Dahlia-Dry/34346-bikelight/34346-Slides.pdf

## 34346 Networking Technologies and Application Development for IoT

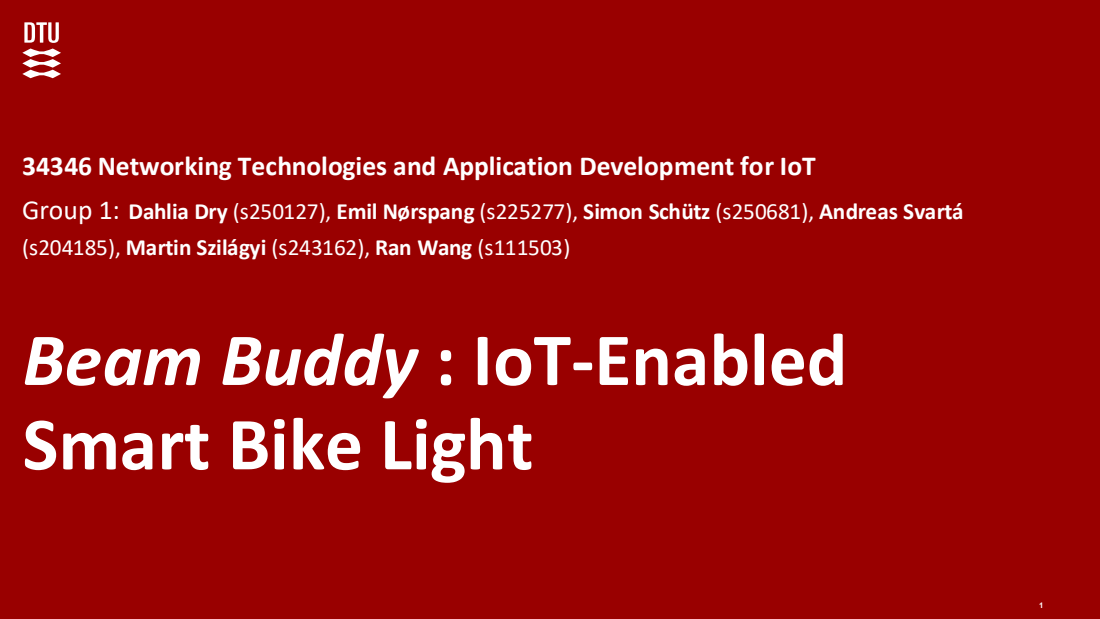
[picture p3: page 1]

Group 1: Dahlia Dry (s250127), Emil Nørspang (s225277), Simon Schütz (s250681), Andreas Svartá
(s204185), Martin Szilágyi (s243162), Ran Wang (s111503)
Beam Buddy : IoT-Enabled
Smart Bike Light

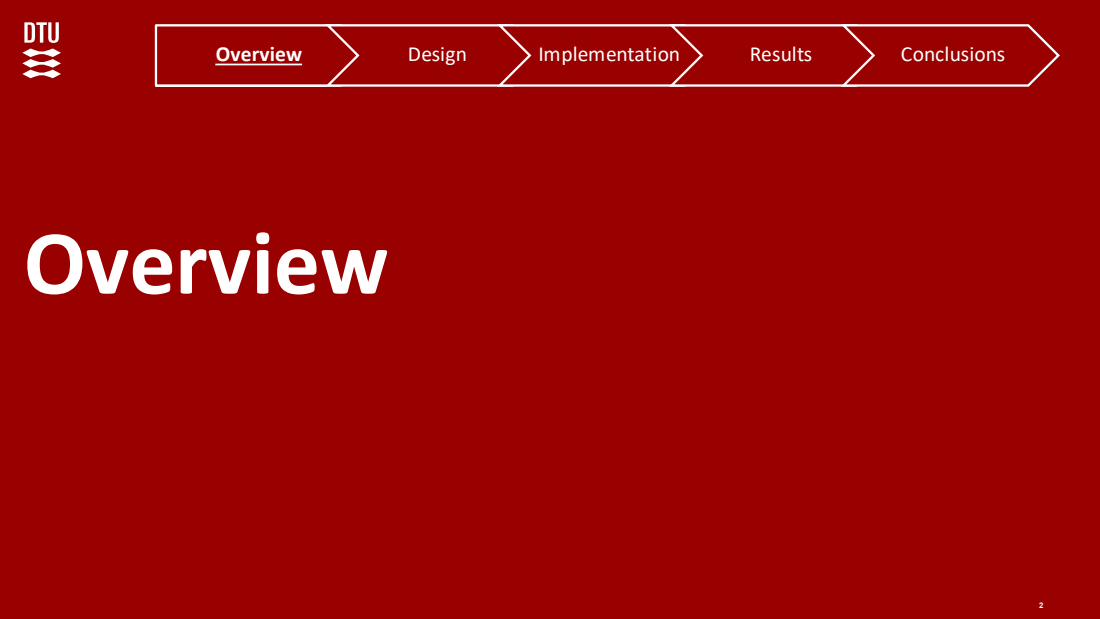
[picture p4: page 2]
Overview; Design; Implementation; Results; Conclusions

# Problem statement

## Bike lights are a critical safety component for any cyclist, but they are often

unreliable (run out of battery), easily stolen, or easy to forget.

3

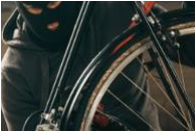
[picture p5: figure]
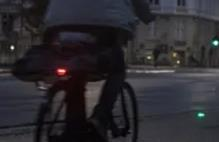
[picture p6: figure]

# Our Solution

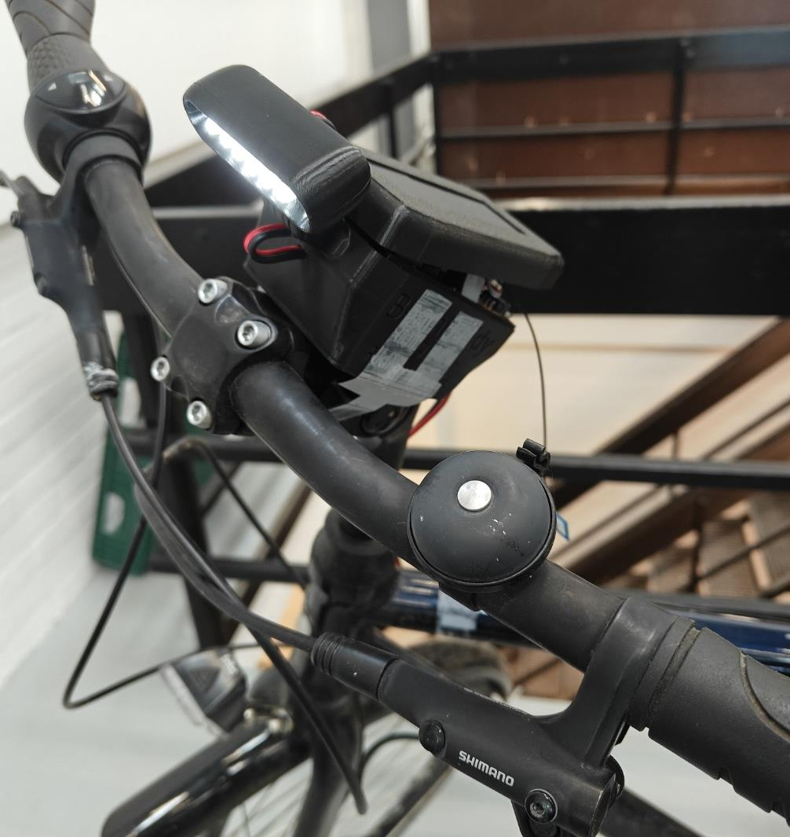
[picture p7: figure]

## - front and rear light - turns on automatically with motion/darkness - theft alarm with RFID card for locking/unlocking the bike when parked - solar charging + audible warning for low battery - Web interface for visualizing operation mode, last seen location, and battery status

4

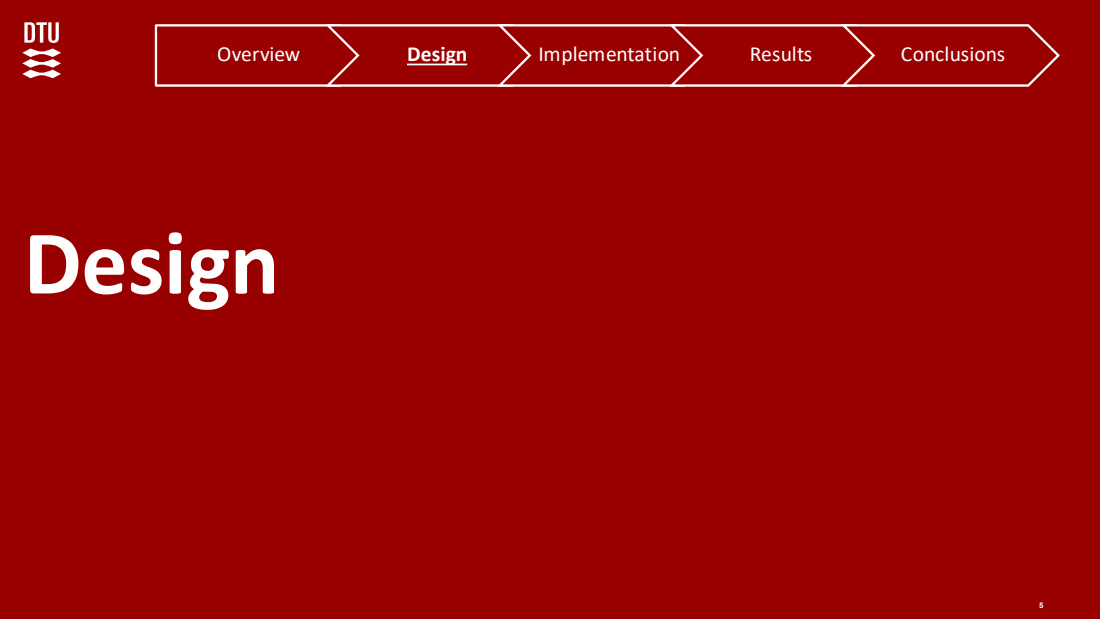
[picture p8: page 5]
Design; Overview; Implementation; Results; Conclusions

# Design

# - prototype

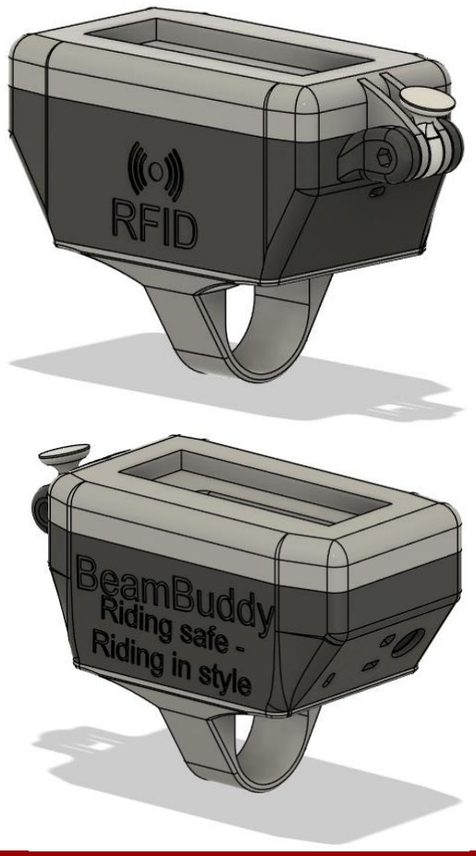
[picture p9: figure]

6

Based on an HT

-CT62 with features:

- Automatic lights w. overwrite button • GPS-tracking using WiFi and GNSS • Movement and light sensors • RFID lock • Theft alarm system • LoRaWAN wireless communication • App communication • Solar & 5V charging capabilities • UV secure casing

# Enclosure

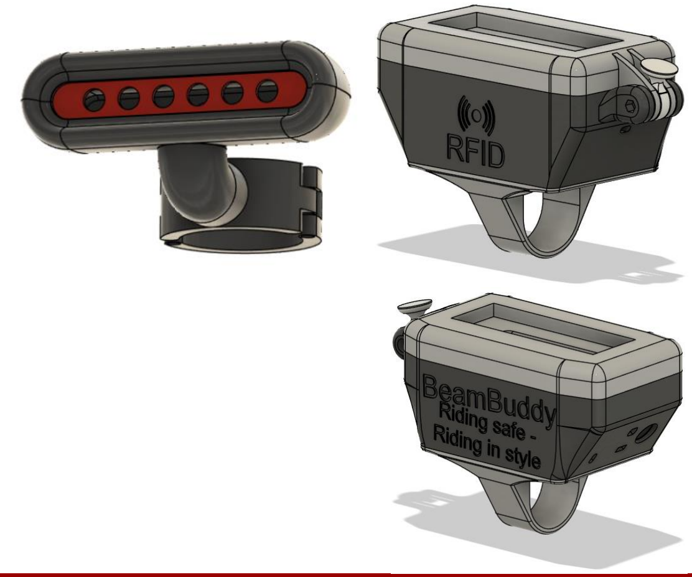
[picture p10: figure]

7

- Waterproof capable
- UV resistant
- Secure anti-theft mounting
- 3D Printed
- PETG casing

# Hardware Design

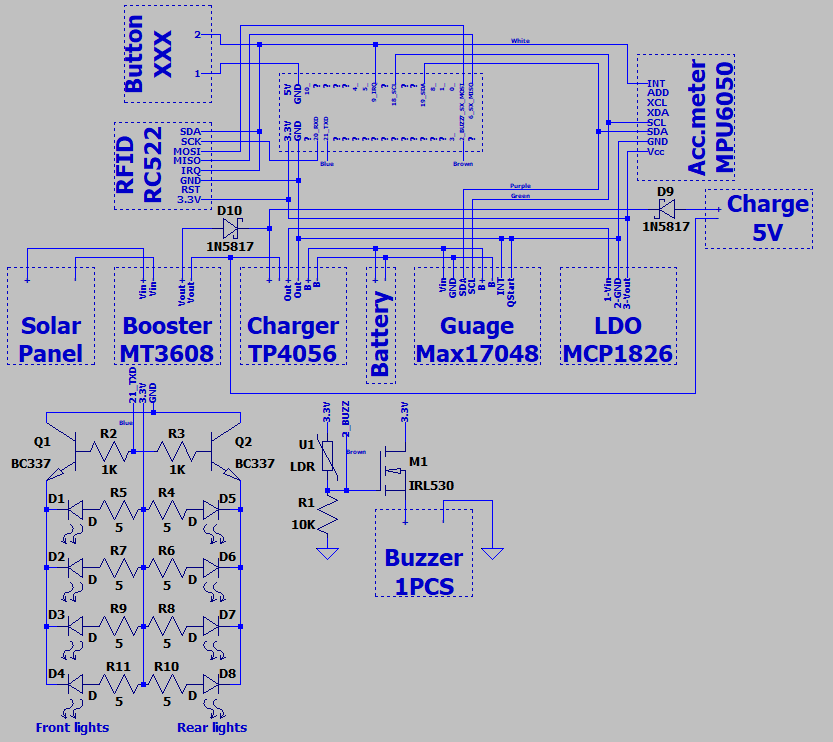
[picture p11: figure]

8

- Heltec HT

-CT62 Development Board (ESP32

framework with an SX1262)

- MT3608 Booster • TP4056 Charging circuit • ICR18650-26J battery (3.7V 2600mAH) • MAX17048 Battery Guage • MCP1826 LDO • RC522 RFID read/writer • MPU6050 Accelerometer • 1N5817 Diode protection • BC337 BJT controlling lights • IRL530 MOSFET controlling buzzer

# Software Design

9

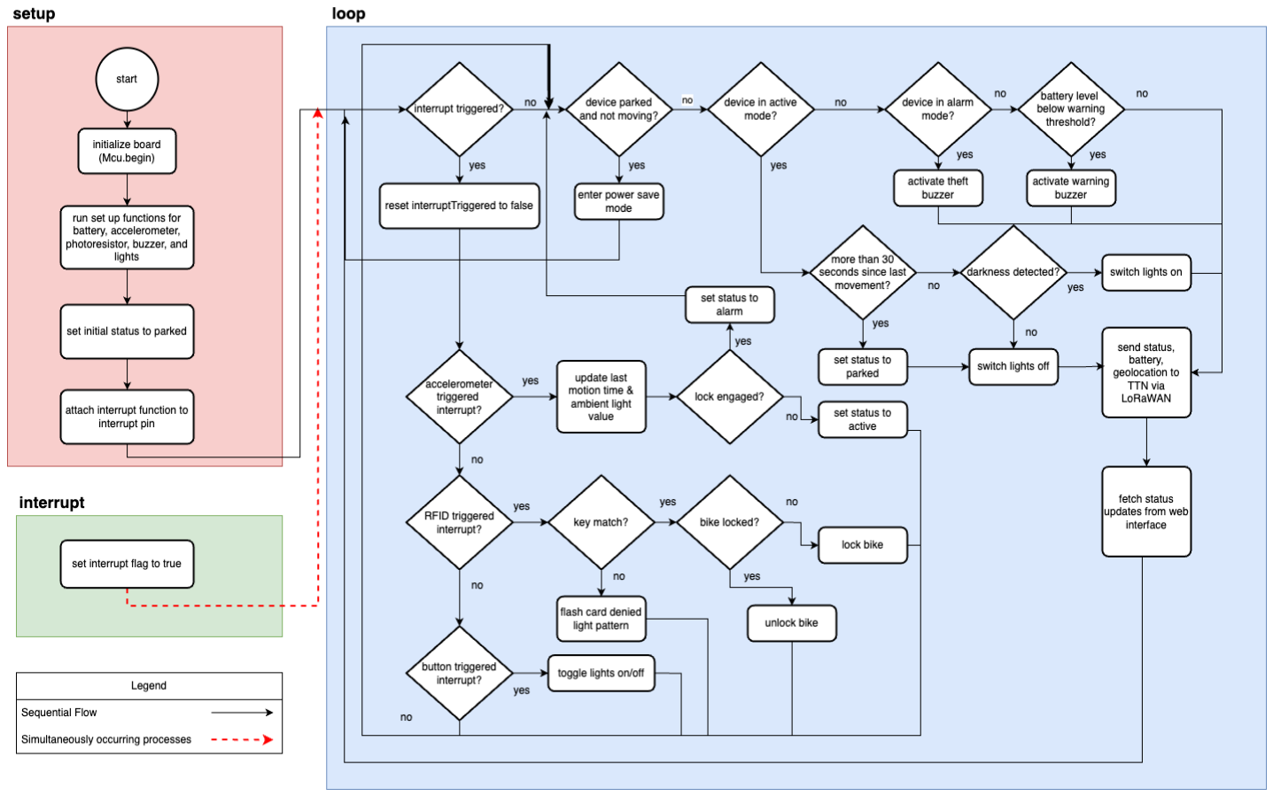
[picture p12: figure]

Operating Modes:
- Storage (deep sleep)
- Parked (locked or unlocked)
- Alarm
- Active

Single interrupt triggered by accelerometer, RFID, or button

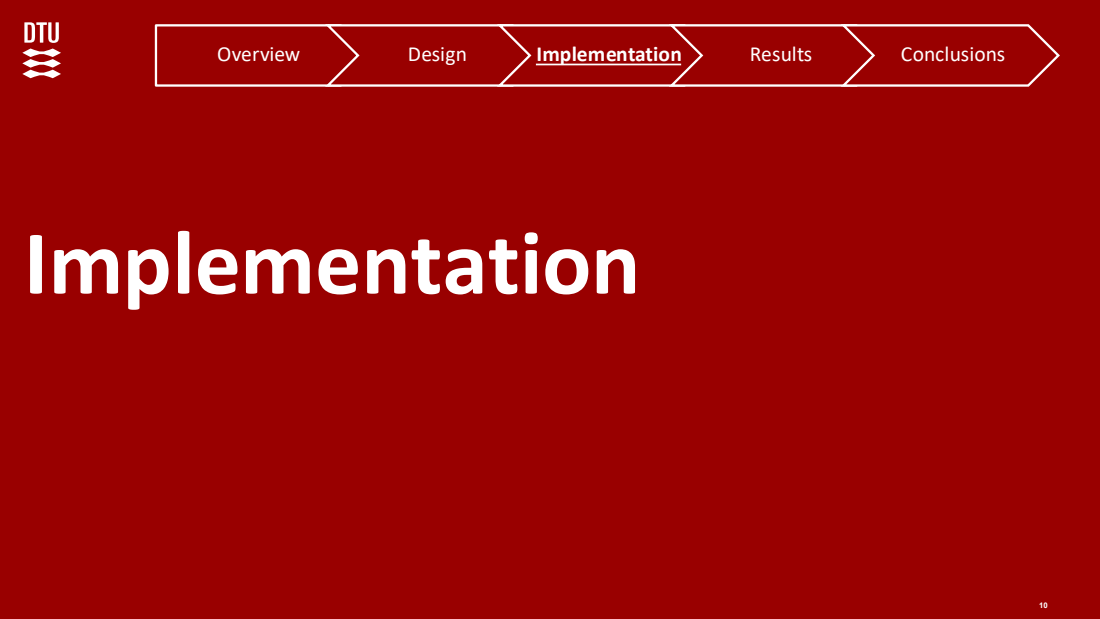
[picture p13: page 10]
Implementation; Overview; Design; Results; Conclusions

# LED Light

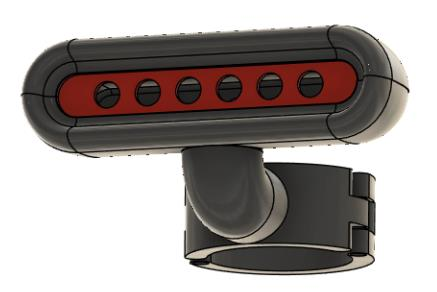
[picture p14: figure]

11

- Automatic turn on/off with motion/light
- Manual overwrite function
- Power efficient visibility light
- Front and rear light
- Angle adjustable front light

# RFID Lock + Theft Alarm

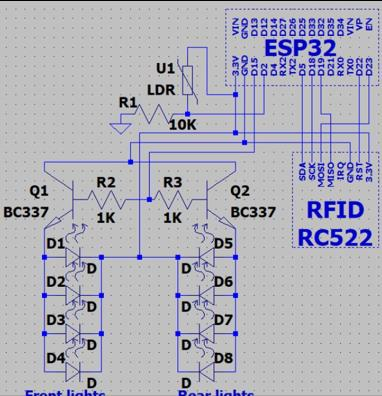
[picture p15: figure]

12

- Rolling FOB – capable
- Multiple Tags
- Locking, unlocking & error light indication
- Movement activated theft alarm
- Audible alarm

# Network technology - LoRaWAN

13

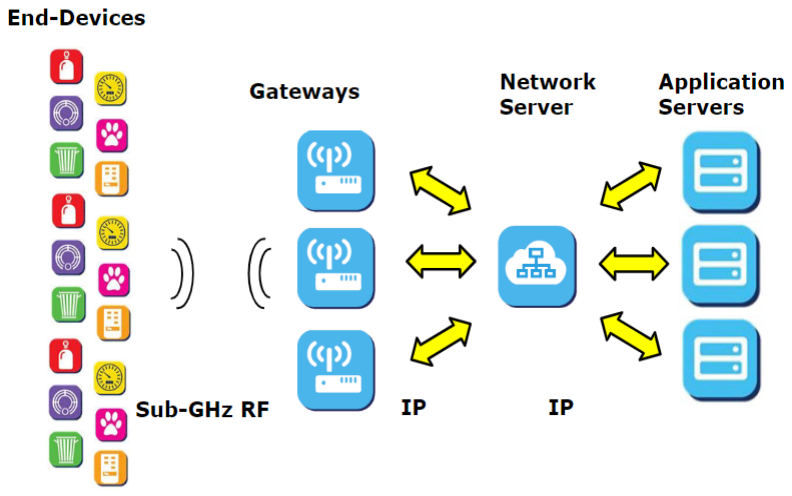
[picture p16: figure]

- Advantages:
– Long range
– Low power consumption
– Cost effective + scalable – Public network (TTN)
- Disadvantages:
– Inconsistent coverage
– susceptible to interference

# Geolocation – WiFi Scanning

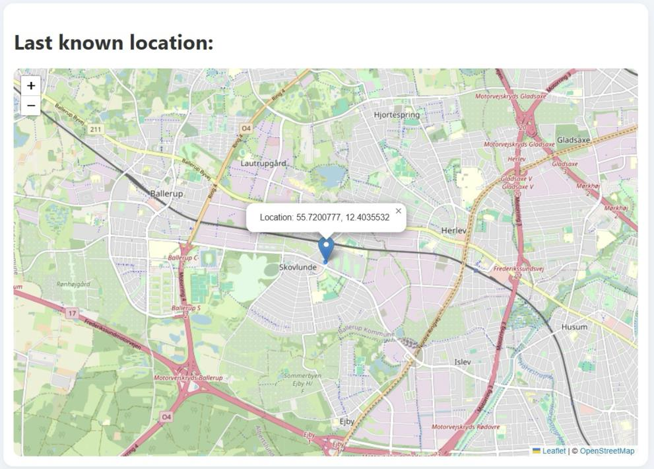
[picture p17: figure]

14

Method:
- The ESP32 board scans for nearby WiFi networks.
- MAC addresses are filtered and compressed.
- Payload of valid MAC addresses + RSSI sent to TTN via LoRaWAN
- Webhook forwards payload to application server (deployed on Railway).
- Google API queries MAC address data and returns geolocation.

# Network technology – Web Integration

15

Comparison of web integration opportunities on TTN. Webhook fits the requirements best.

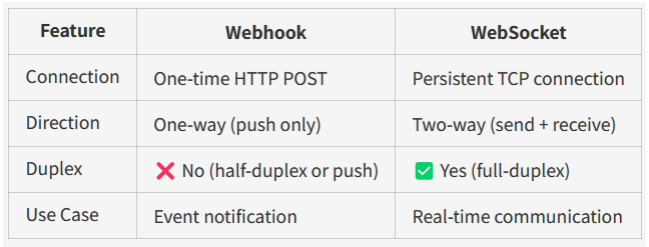
[picture p18: figure]

# Network technology – Application server

16

Backend:
Python
- Parses the JSON structure.
- Decompresses the data.
- Saves the latest data locally in a JSON file to track recent activity.
- Utilizes Google Geolocation API to get position

Frontend:
JavaScript and HTML and CSS.

# Power supply

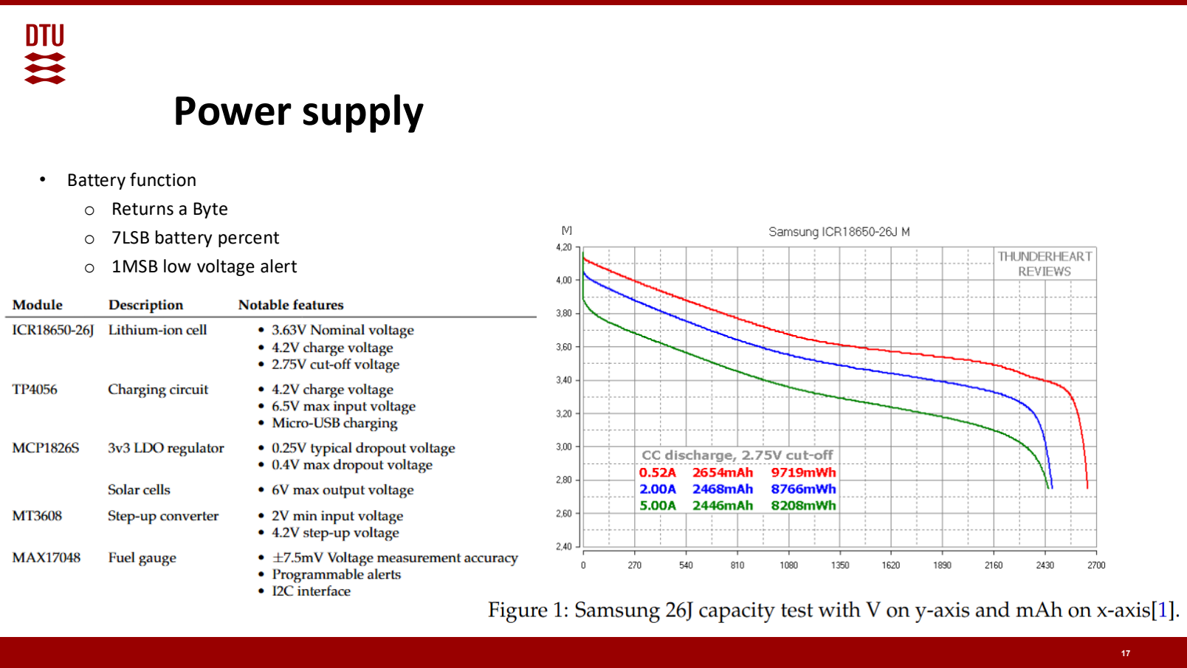
[picture p19: page 17]

17

- Battery function
- Returns a Byte
- 7LSB battery percent
- 1MSB low voltage alert

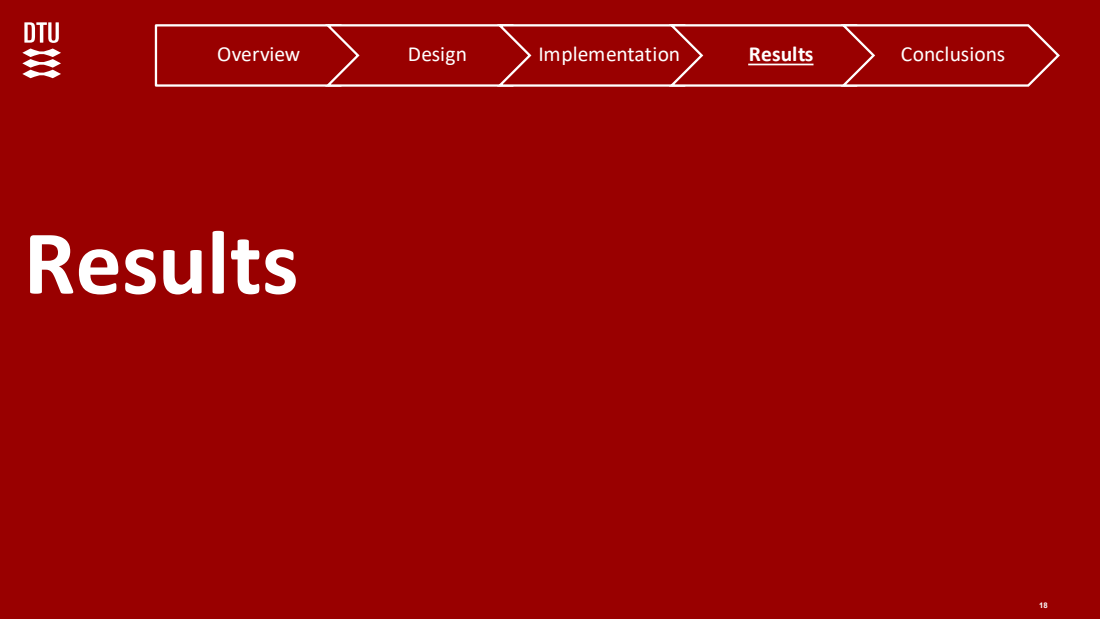
[picture p20: page 18]
Results; Overview; Design; Implementation; Conclusions

# Final Product

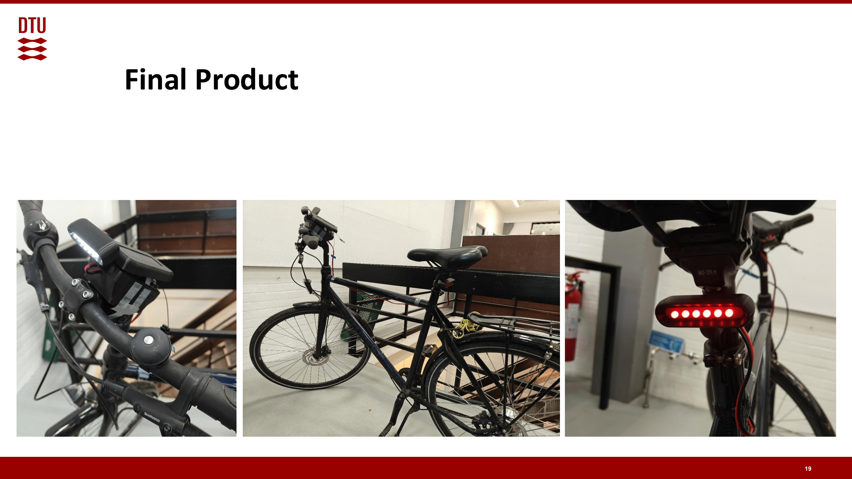
[picture p21: page 19]

19

# Graphical User Interface

20

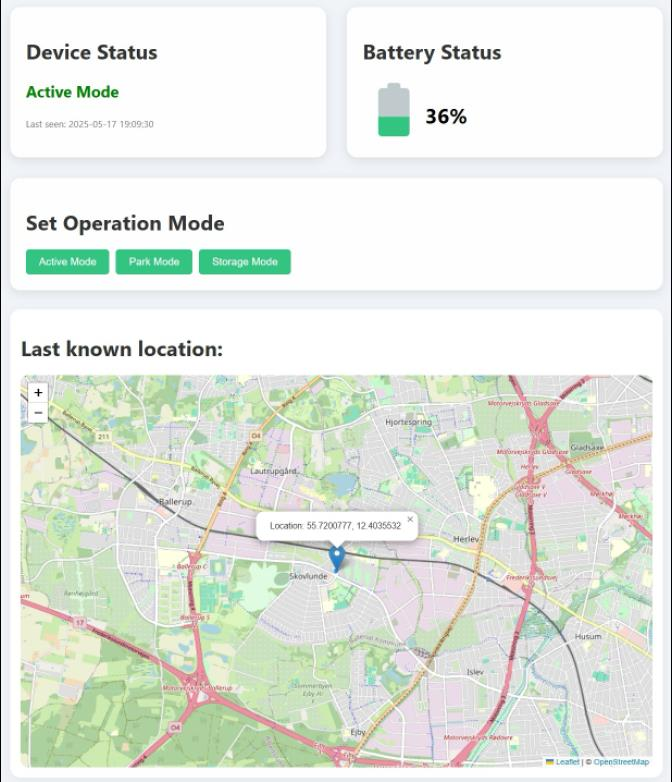
[picture p22: figure]

- Displays battery status, last known location, and current operation mode
- Stores last known data in a JSON file
- Option to set operation mode
- Works on mobile and desktop

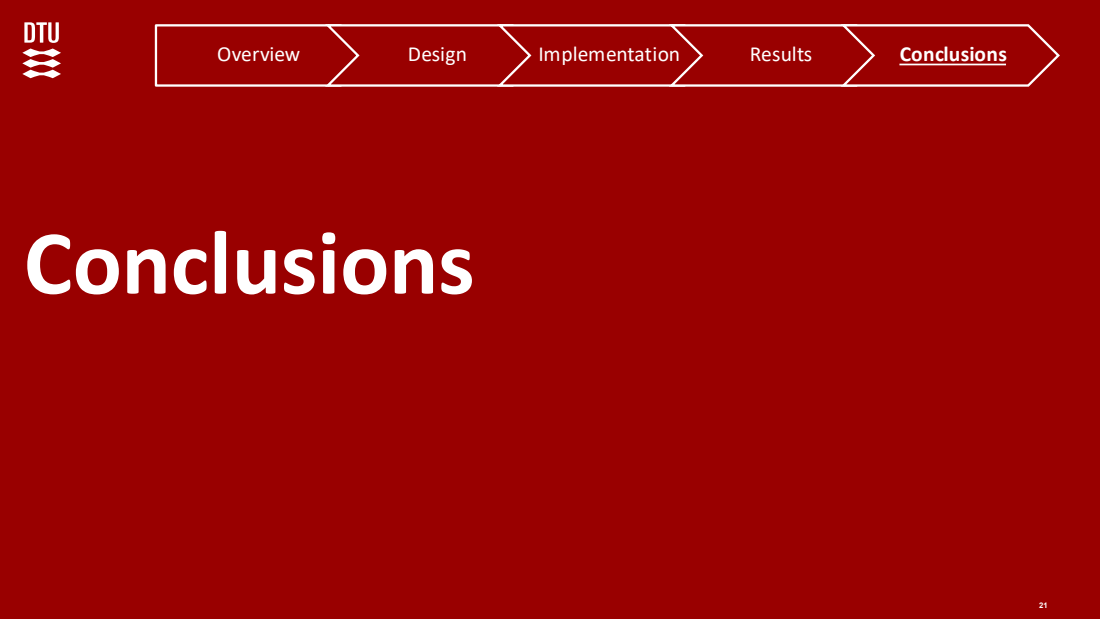
[picture p23: page 21]
Conclusions; Overview; Design; Implementation; Results

# Future Improvement: Solar charging

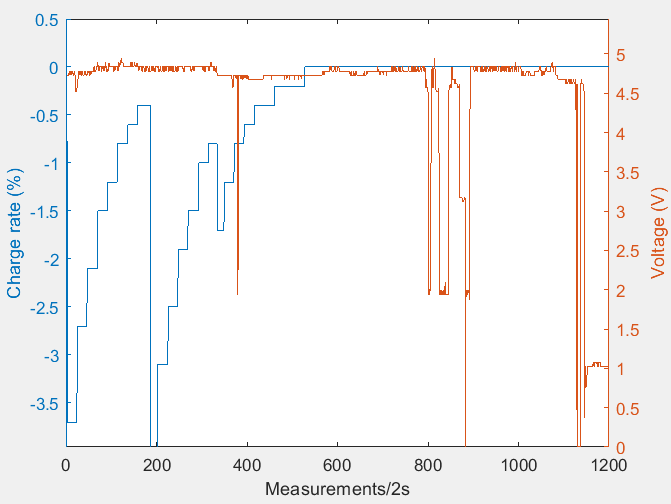
[picture p24: figure]

22

- Problems:
- Produces 5V in direct sunlight.
- At charging circuit voltage too close to charging voltage.
- Step up converter set too low 4.25V, and not suitable for fluctuating inputs.
- Solutions:
- More efficient solar panels with a buck converter.
- Adjusting the step-up converter or removing it.
- Dedicated solar charging circuit.

# Future Improvement: GNSS for Geolocation

Dual mode: WIFI scanning and GNSS module.

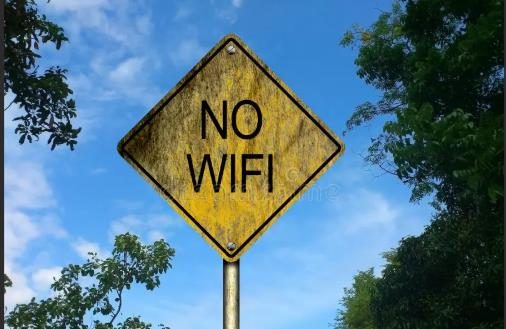
[picture p25: figure]

- In urban area send MAC address and RSSI to Google API to get geolocation.
- In rural area when no WIFI available, use GNSS.(Not in the final code due to restrictions)

23

# Summary

- Complete Successes
- 3D design (compact enclosure) w/front and rear light
- Low power geolocation w/wifi scanning
- Lights responsive to motion + ambient light
- Web interface displaying current battery, status and last known location
- Partial Successes
- RFID anti theft lock (needs further testing)
- Set status from web interface w/LoRaWAN downlink (unreliable)
- Limitations
- Brownout issue causing reset
- Sparse LoRaWAN network coverage
- No deep sleep mode

24
