Dahlia-Dry/34346-bikelight/Schematic and PCB/Beambuddy3D.png

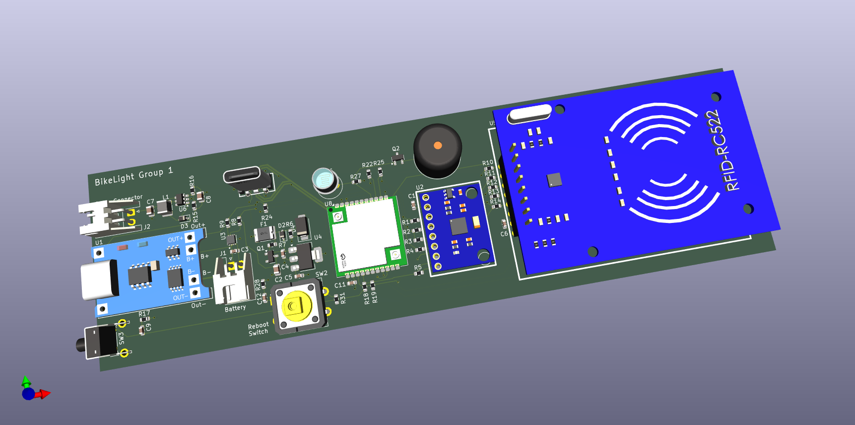
Schematic and PCB/Beambuddy3D.png
