Dahlia-Dry/34346-bikelight/Schematic and PCB/BeamBuddySCH.pdf

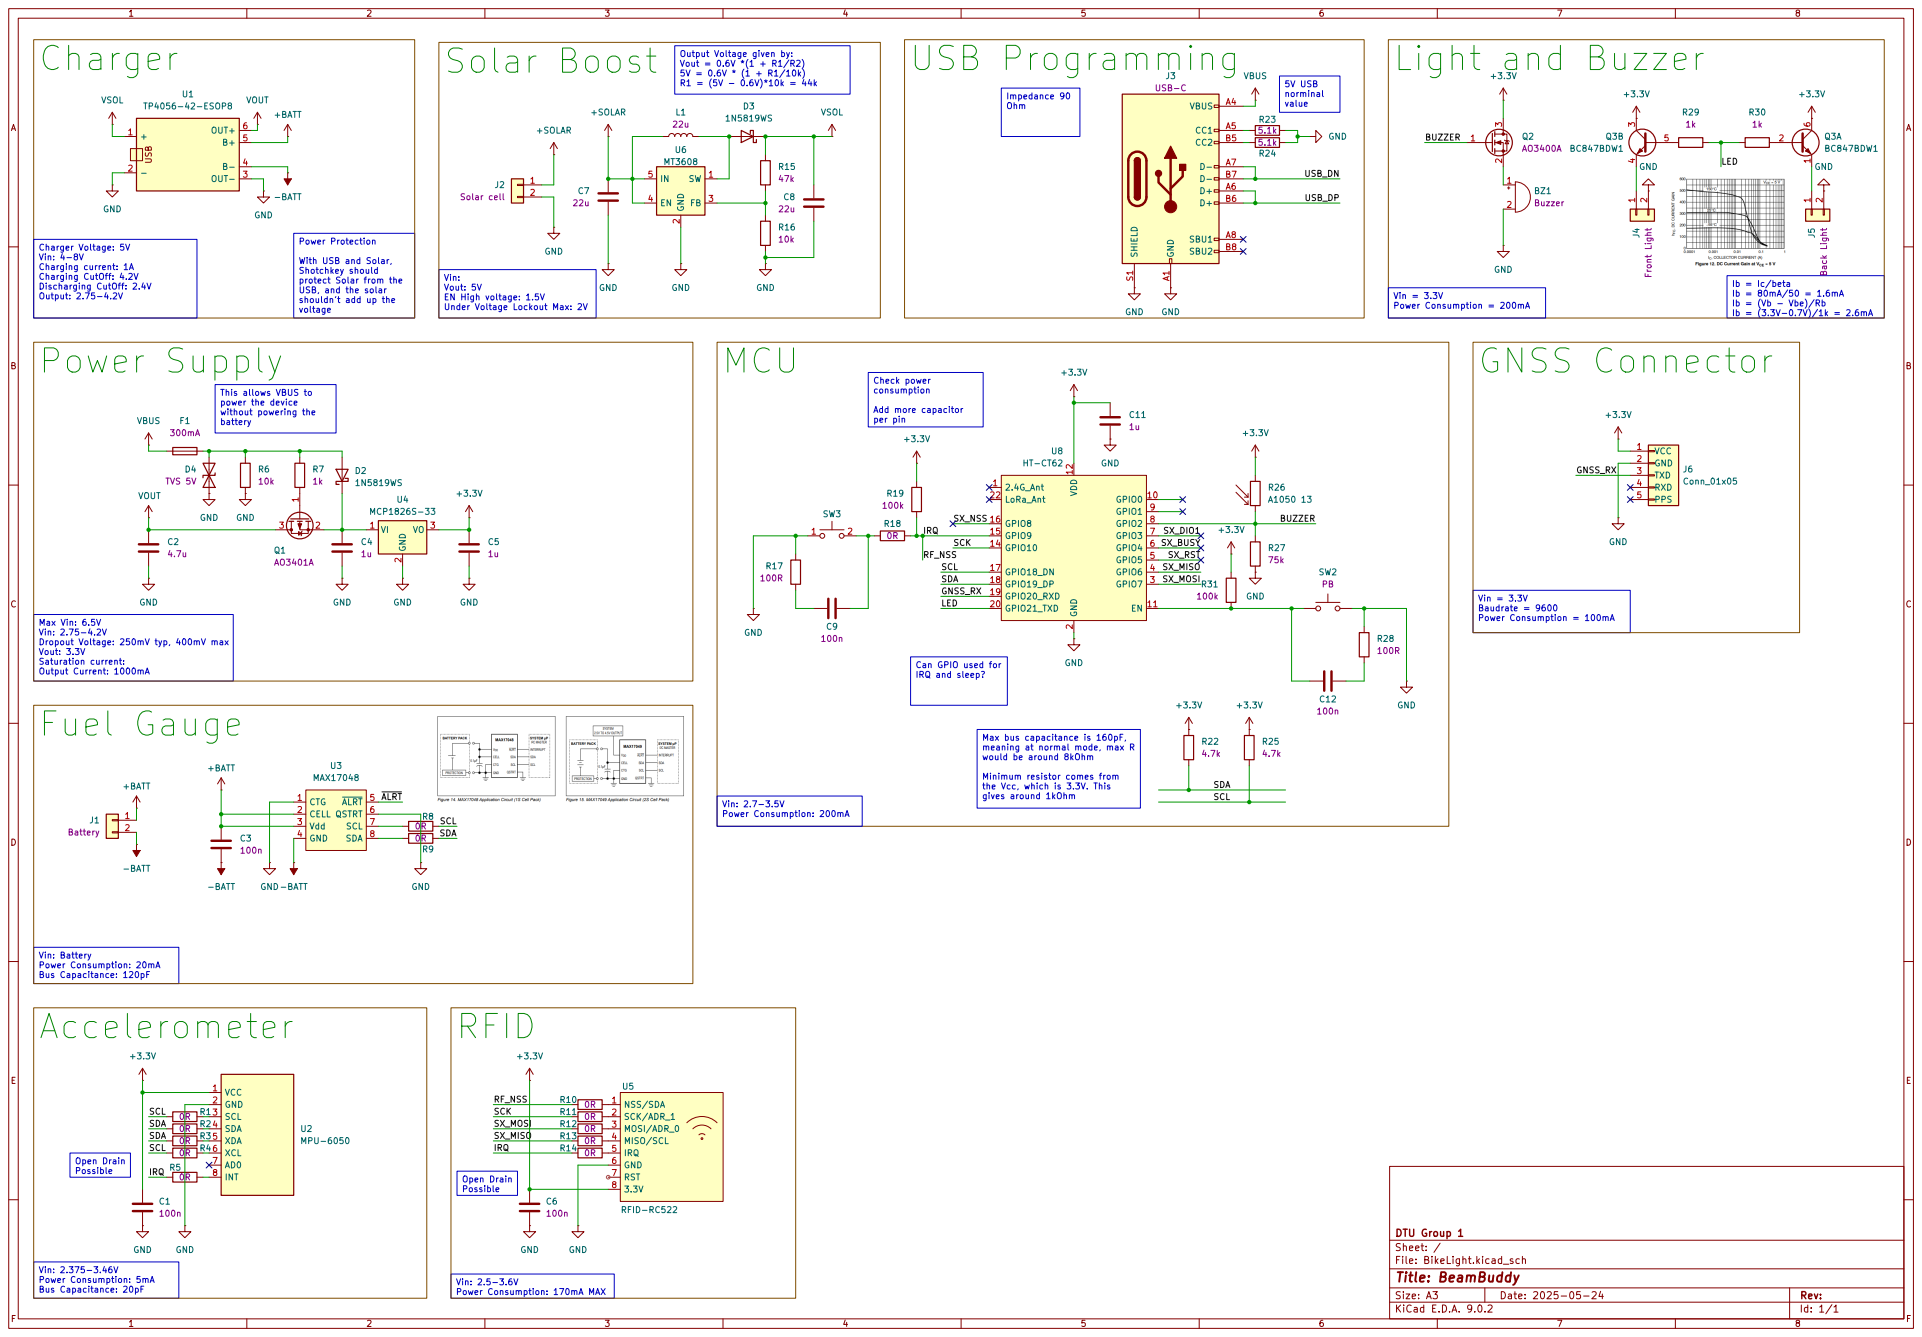
[picture p27: page 1]
