Dahlia-Dry/34346-bikelight/Schematic and PCB/BeambuddyPCB.pdf

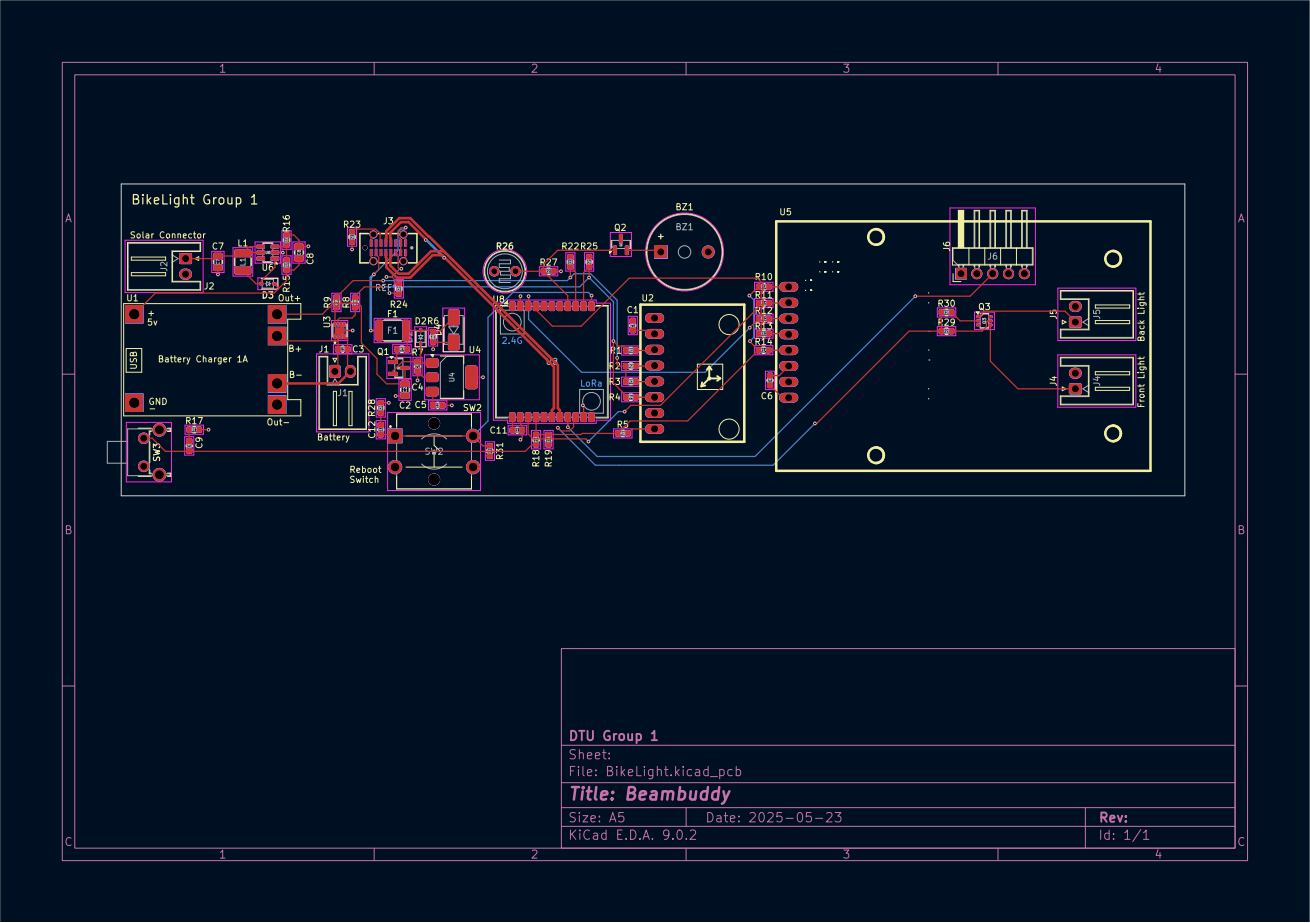
[picture p28: page 1]
