Dahlia-Dry/34346-bikelight/RFIDReader.cpp

/*
* Beam Buddy : IoT-Enabled Smart Bike Light
* 34346 - Networking Technologies and Application Development for IoT, Spring 2025
* Group 1
* Code file for RFID card reader functions
*/

#include "RFIDReader.h"
#include <SPI.h>

RFIDReader::RFIDReader(uint8_t sckPin, uint8_t misoPin, uint8_t mosiPin, uint8_t ssPin, uint8_t rstPin)
    : _sckPin(sckPin), _misoPin(misoPin), _mosiPin(mosiPin), _ssPin(ssPin), _rstPin(rstPin), mfrc522(ssPin, rstPin) {}

void RFIDReader::setup() {
    SPI.begin(_sckPin, _misoPin, _mosiPin, _ssPin);
    mfrc522.PCD_Reset();
    mfrc522.PCD_Init();

    Serial.begin(115200);
    Serial.println("RFID Access Control System initialized");
    Serial.println("Ready to read card\n");
}

/* read ID of card */
String RFIDReader::readUID() {
    String content = "";
    for (byte i = 0; i < mfrc522.uid.size; i++) {
        content += String(mfrc522.uid.uidByte[i] < 0x10 ? " 0" : " ");
        content += String(mfrc522.uid.uidByte[i], HEX);
    }
    content.toUpperCase();
    return content.substring(1);
}

/*detect if card is in field */
bool RFIDReader::detectCard(){
  if (!mfrc522.PICC_IsNewCardPresent() || !mfrc522.PICC_ReadCardSerial()) {
        return false;
  }
  else{
        return true;
  }
}

/*check read UID against known key UIDs */
bool RFIDReader::checkAccess(const String& allowedUID1, const String& allowedUID2) {
    Serial.print("UID tag:");
    String uid = readUID();
    Serial.println(uid);

    if (uid == allowedUID1 || uid == allowedUID2) {
        Serial.println("ACCESS GRANTED.\n");
        return true;
    } else {
        Serial.println("ACCESS DENIED!\n");
        return false;
    }
}
