Dahlia-Dry/34346-bikelight/(commit log)

2025-05-08 Added battery function
2025-05-17 Changed battery file name for sure
2025-05-17 Added back battery
2025-05-17 Accelerometer comments
2025-05-24 Added schematic and PCB
    [bom.csv, designators.csv, positions.csv]
2025-05-25 Moddified schematic to reflect current hardware configuration
